kanglc/Hashtag/Pics/Hashtag_test_setup/msg-1409573976-1037.jpg

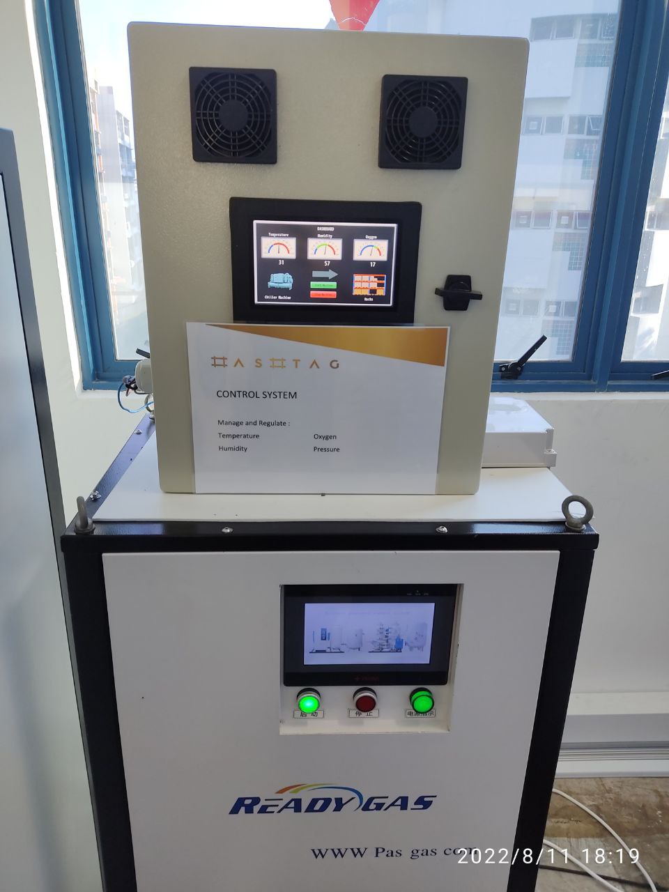
Pics/Hashtag_test_setup/msg-1409573976-1037.jpg
