kanglc/Hashtag/Docs/2-box-Control.docx

Liquid Nitrogen Tank

Frozen Pallet

Release valve

Sensor

Insulated Box

Liquid Nitrogen Tank

Frozen Pallet

Thermal Controller
