kanglc/Hashtag/Docs/thermal_controller_blockdiagram.pptx

Block Diagrams

## Slide 2

Thermal Controller

AC-DC
Converter

+24V

AC 230V

+5V

+12V

+5V

+12V

+24V

Relay Module

From Temp
Sensor

Modbus

Max485
Module

Microcontroller

NC

To Cryogenic
Control Valve

RTC

SD
Module

## Slide 3

Box 1 (RK330)

AC-DC
Converter

DC-DC
Converter

DC-DC
Converter

AC 230V

+24V

+12V

+5V

+12V

Microcontroller
(Arduino Uno)

10

DI

Max485
Module

RTC

LCD

RELAY

+5V

+12V

RK330-2
Sensor

GND

8

8

DE

RE

A

B

Modbus

SD
Module

+5V

Manual
Mode

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
Solenoid
Valve

ON/OFF

A3

3

4

IN1

IN2

COM

NO

+24V

GND

GND

## Slide 4

Box 1 (DHT22)

AC-DC
Converter

DC-DC
Converter

DC-DC
Converter

AC 230V

+24V

+12V

+5V

+12V

Microcontroller
(Arduino Uno)

+5V

DHT22
Module

GND

8

DHTPIN

+

SD
Module

+5V

Manual
Mode

GND

5

7

CLK

DAT

RTC

LCD

RELAY

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
Solenoid
Valve

ON/OFF

A3

3

4

IN1

IN2

COM

NO

+24V

GND

GND

## Slide 5

Box 1 (Max31855)

AC-DC
Converter

DC-DC
Converter

DC-DC
Converter

AC 230V

+24V

+12V

+5V

+12V

Microcontroller
(Arduino Uno)

10

+5V

CLK

Max31855
Module

GND

9

8

CS

DO

+

SD
Module

+5V

Manual
Mode

GND

5

7

CLK

DAT

RTC

LCD

RELAY

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
Solenoid
Valve

ON/OFF

A3

A0

A1

IN1

IN2

COM

NO

+24V

GND

GND

## Slide 6

Box 1 (Max31865+PT100)

AC-DC
Converter

DC-DC
Converter

DC-DC
Converter

AC 230V

+24V

+12V

+5V

+12V

Microcontroller
(Arduino Uno)

12

+5V

CLK

Max31865
Module

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
PT100

SD
Module

+5V

Manual
Mode

GND

5

7

CLK

DAT

RTC

LCD

RELAY

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
Solenoid
Valve

ON/OFF

A3

3

4

IN1

IN2

COM

NO

+24V

GND

GND

## Slide 7

Box 2 (Mega, Max31865+PT100)

AC-DC
Converter

DC-DC
Converter

DC-DC
Converter

Max31865
Module

AC 230V

+24V

+5V

+9V

+5V

+9V

Microcontroller
(Arduino Mega)

8

CLK

SD

Manual
Mode

MISO

GND

50

10

11

DI

CS

+

PT100

SCK

SS

53

52

9

GND

DO

MOSI

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
Module

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
ON/OFF

28

22

IN1

RELAY

COM

+24V

GND

Solenoid
Valve

20

21

SDA

SCL

GND

IN2

NO

## Slide 8

Distributed Controller

Main Controller (Mega)

AC 230V

AC-DC
Converter

+24V

Sub Controller (Uno) 1

Sub Controller (Uno) 2

Sub Controller (Uno) 3

Sub Controller (Uno) 4

DC-DC
Converter

Microcontroller (Uno)

+12V

Servo Motor

+5V

+12V

RTC

+5V

Microcontroller (Mega)

Max485
Module

Max485
Module

RK330
Sensor

Max485
Module1

Display

Max485
Module2

Max31865
Module

PT100
Sensor

Relay
Module

Max485
Module3

SD
Module

Max485
Module4

## Slide 9

Distributed Controller

+24V

DC-DC
Converter

+12V

DC-DC
Converter

+5V

+5V

Max31865
Module

Max485
Module

+12V

GND

Microcontroller
(Arduino Uno)

4

6

CLK

DI

+

+

PT100

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
Modbus

+12V

RK330-2
Sensor

Arduino
Mega

+24V

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
Max485
Module

DI

1

Modbus

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
SERVO

GND

RO

0

GND

V

G

Notes: Need to update pin numbers and arrow directions.

## Slide 10

Distributed Controller

+24V

DC-DC
Converter

+12V

DC-DC
Converter

+5V

+5V

Max31865
Module

DHT22
Module

+12V

GND

Microcontroller
(Arduino Uno)

4

6

CLK

DI

+

+

PT100

7

5

GND

CS

DO

8

+5V

DHTPIN

+

Arduino
Mega

+24V

GND

+5V

GND

Max485
Module

DI

1

Modbus

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
SERVO

GND

RO

0

GND

V

G

Notes: Need to update pin numbers and arrow directions.

## Slide 11

Master

Max485 Module

Slave 1

Max485 Module

Slave 2

Max485 Module

Slave 4

Max485 Module

Slave 3

Max485 Module

## Slide 12

Program Flowchart

## Slide 13

Setup:
Serial Terminal, Initialize variables, Display LEDs, RTC
Max31865, Relay, Mode and ONOFF Switches, microSD

Display temperature on LEDs & Serial Terminal

Manual Mode?

Read states of MODE and ONOFF switches

*

N

Cont on
next pg

Get time from RTC

Y

Turn on/off Relay and light corresponding LED according to ONOFF switch

Get temperature from Max31865

To*

## Slide 14

Cooling?

Turn on Relay and corresponding LED

N

Turn off Relay and corresponding LED

Temp < Upper Limit?

Turn off Relay and corresponding LED. Set cooling = true

Y

From
prev pg

N

N

Y

Temp < Lower Limit?

Turn off Relay and corresponding LED. Set cooling = false

N

Y

To*
