kanglc/Hashtag/Docs/Muang/2022-11-07_190520_Continental_Space Electronics.pdf

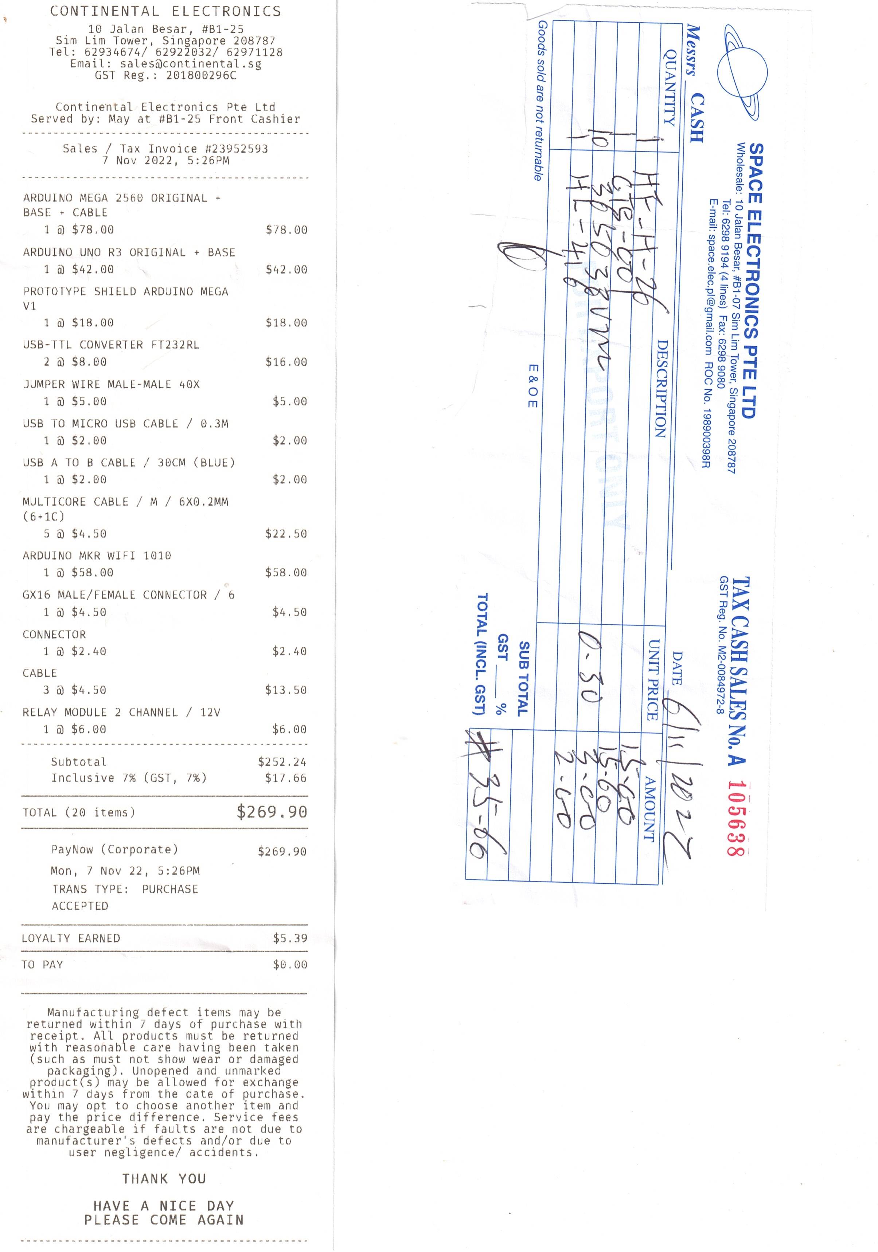
[picture p9: page 1]
