kanglc/Hashtag/Docs/Muang/2022-11-12_Continental Electronics.pdf

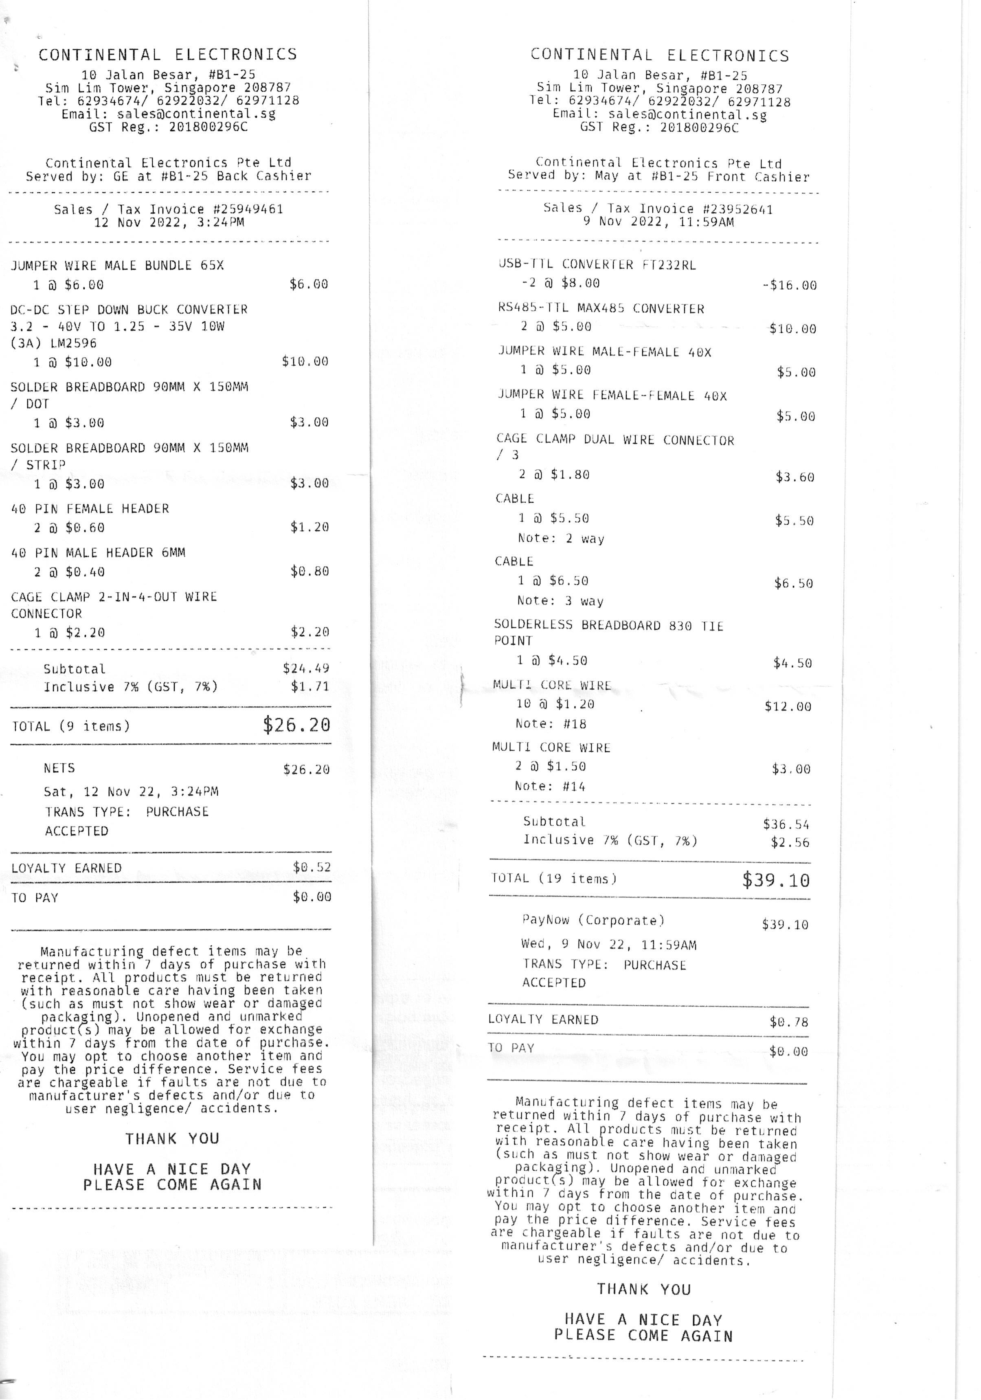
[picture p10: page 1]
