kanglc/Hashtag/Docs/Muang/2022-11-12_E-Top Electronics.pdf

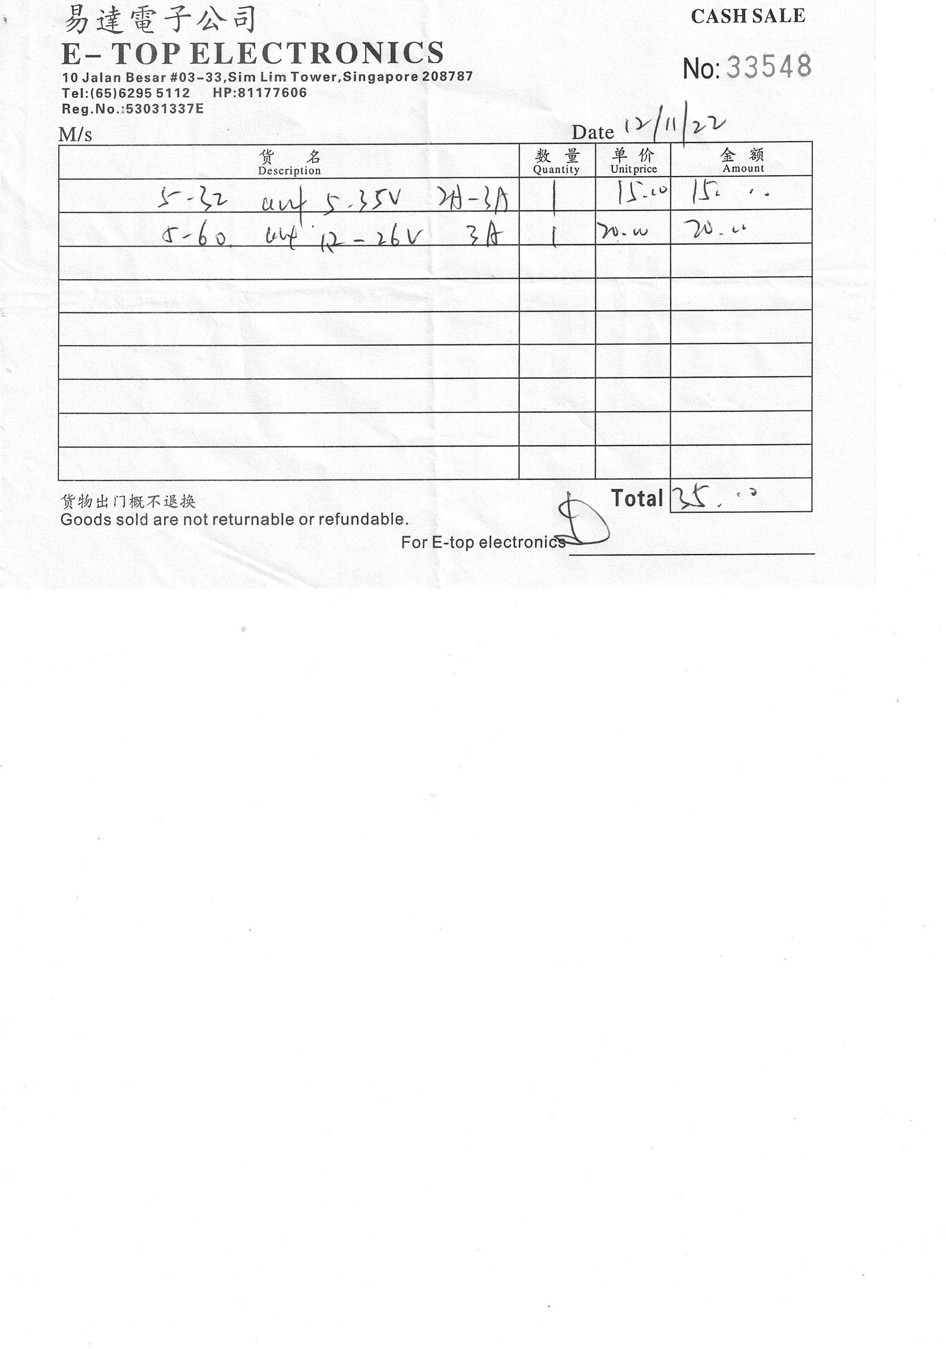
[picture p11: page 1]
