kanglc/Hashtag/Docs/Ref/RK330-02/使用手册.pdf

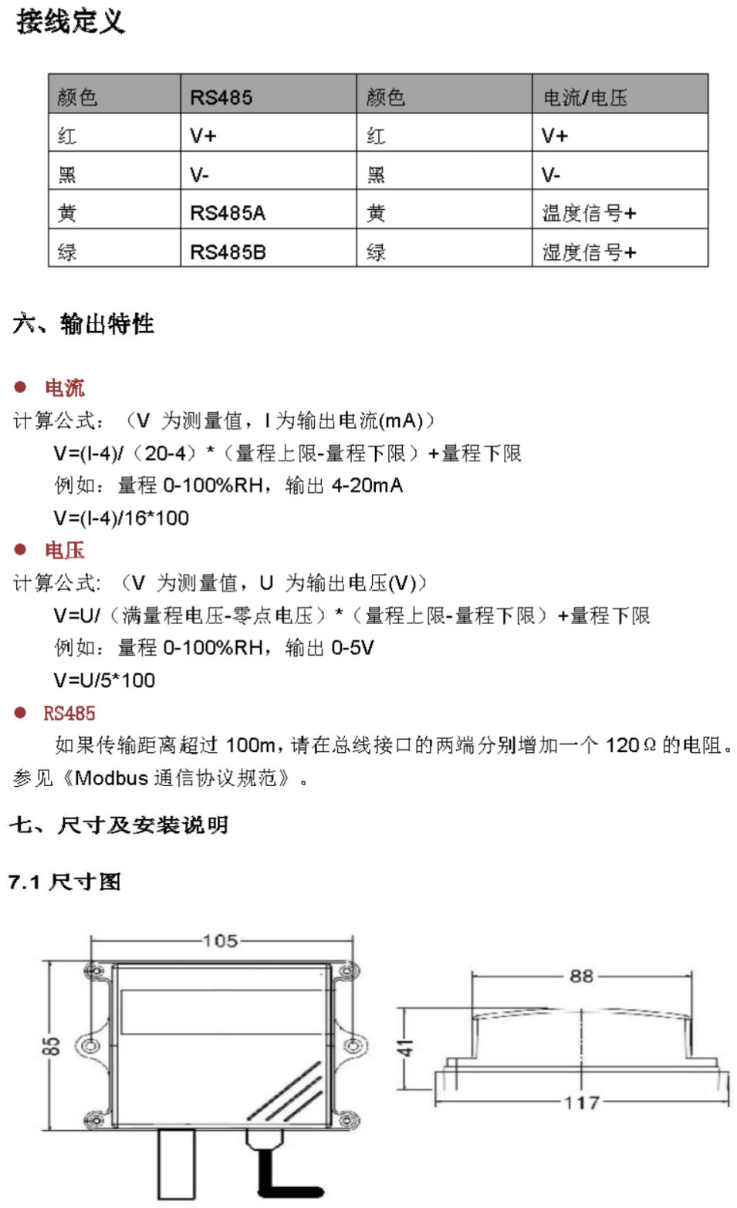
[picture p12: figure]
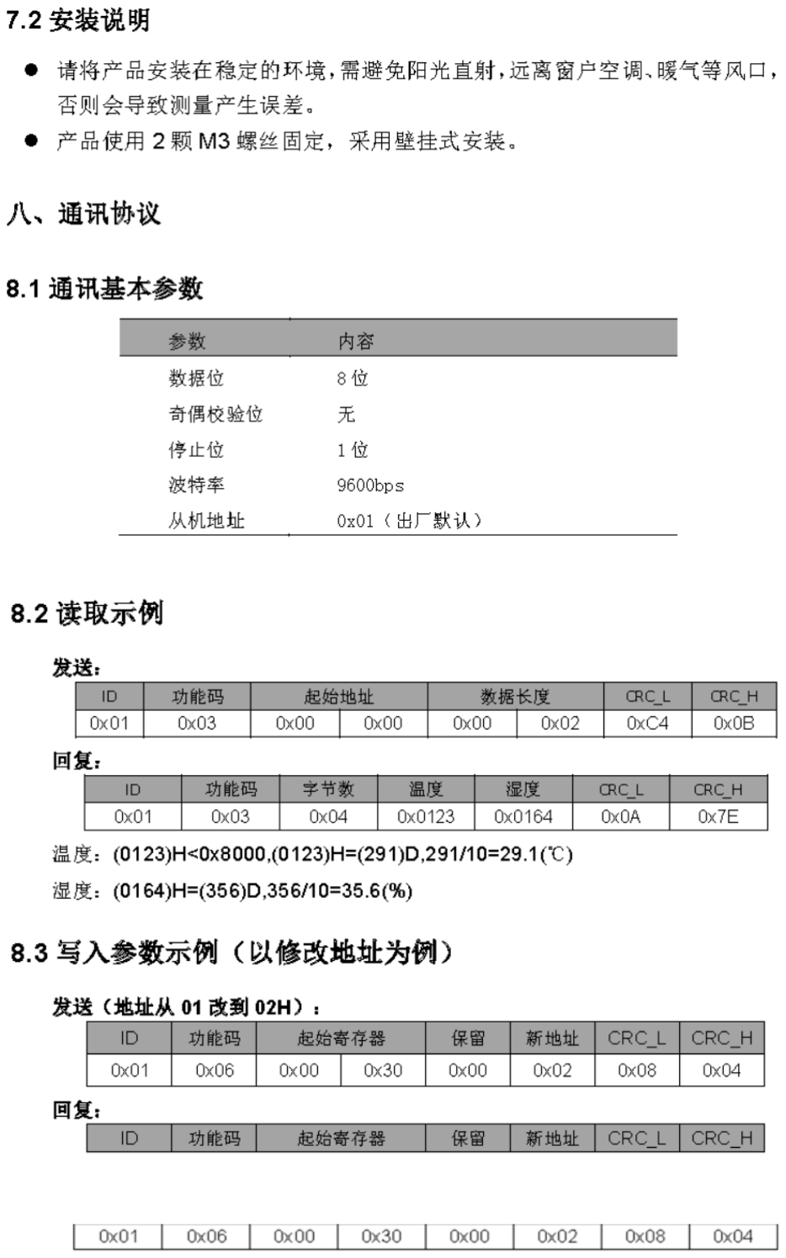
[picture p13: page 2]
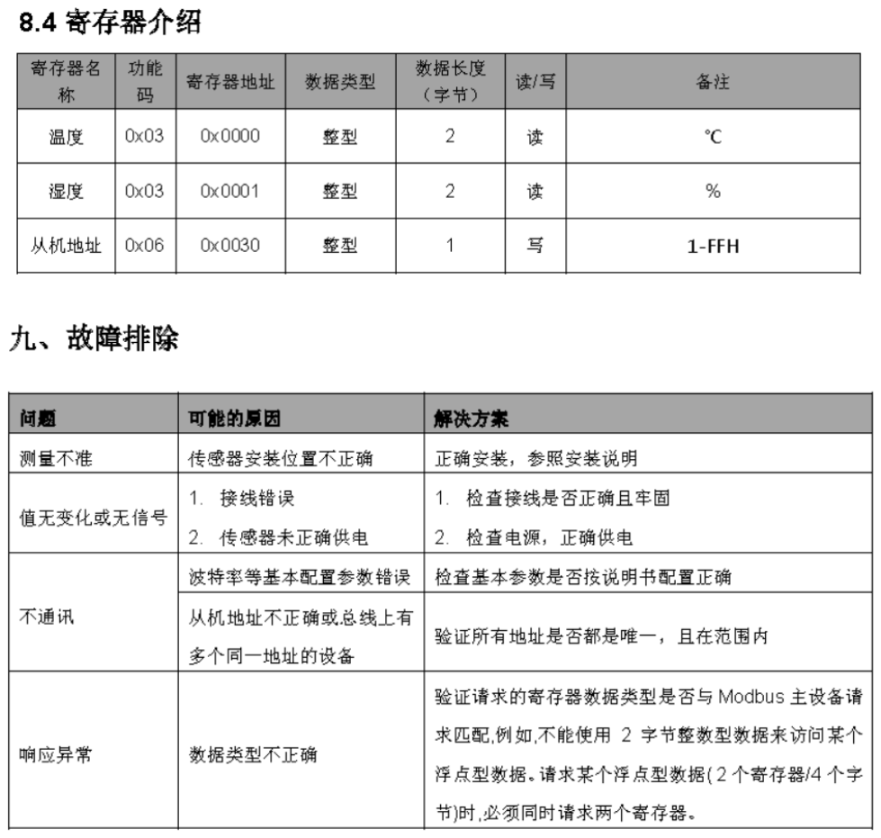
[picture p14: page 3]
