kanglc/Hashtag/Docs/Muang/2022-10-29 2.4inch TFT LCD Shield Tough Display Module.jpg

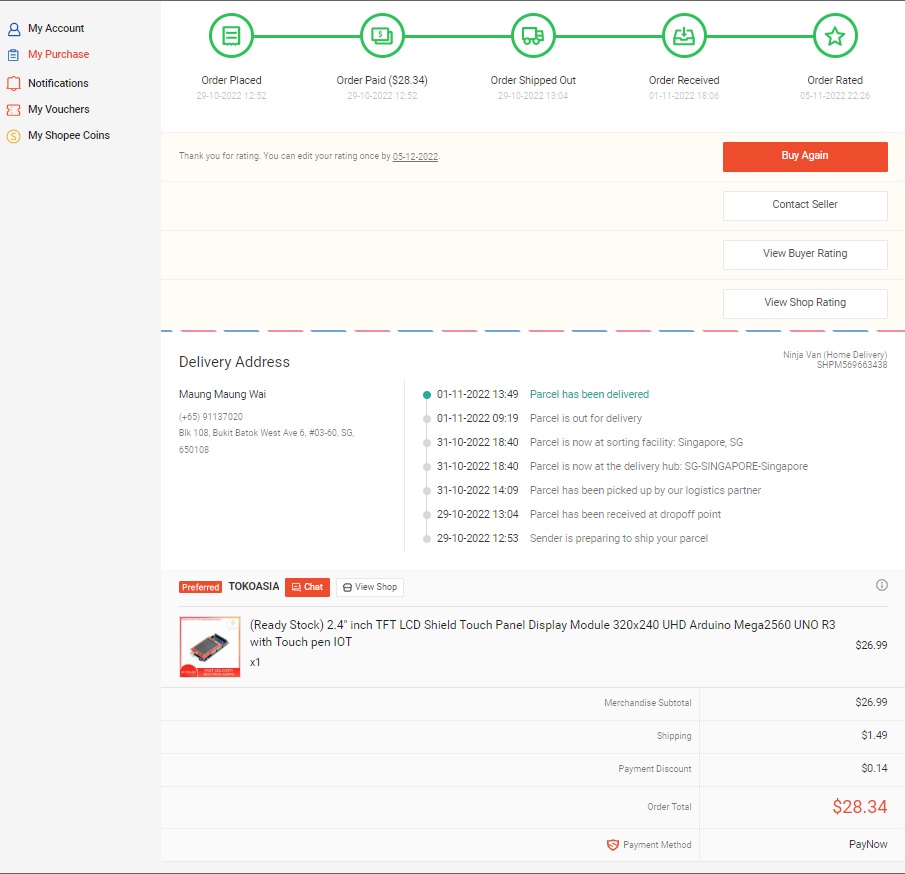
Docs/Muang/2022-10-29 2.4inch TFT LCD Shield Tough Display Module.jpg
