kanglc/Hashtag/Docs/Muang/2022-11-07 3.5inch 320x480 serial tft LCD module display.jpg

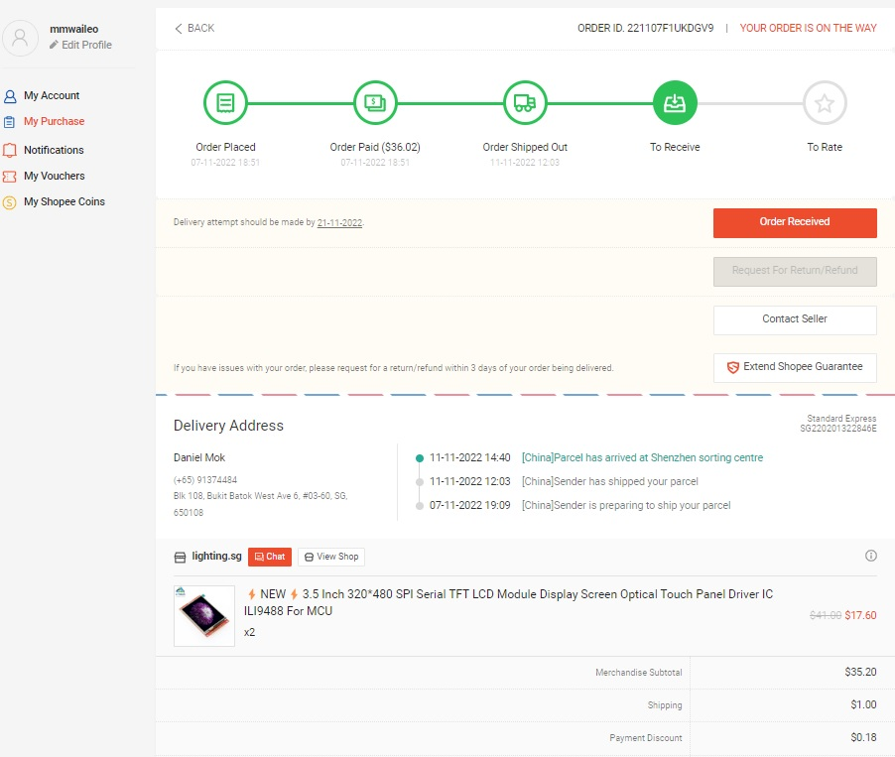
Docs/Muang/2022-11-07 3.5inch 320x480 serial tft LCD module display.jpg
