kanglc/Hashtag/Docs/Muang/2022-11-07 Dupont line 40pcs 20cm male-male.jpg

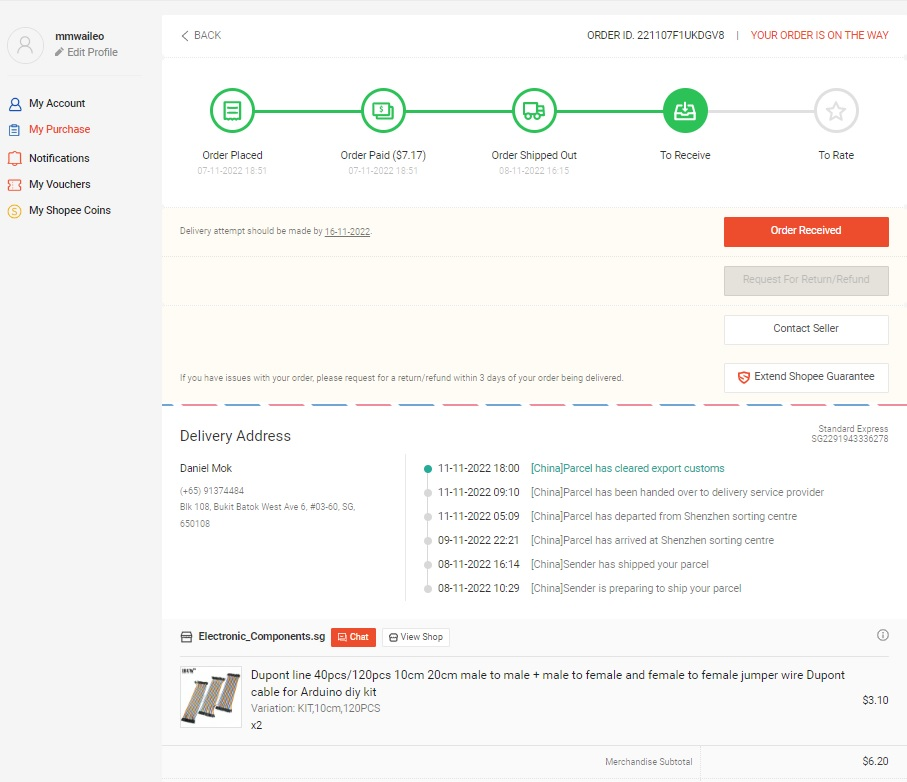
Docs/Muang/2022-11-07 Dupont line 40pcs 20cm male-male.jpg
