kanglc/Hashtag/Docs/Muang/2022-11-07 LM2596 Multi Channel Switching power supply DC-DC 3.3V-5V-12V.jpg

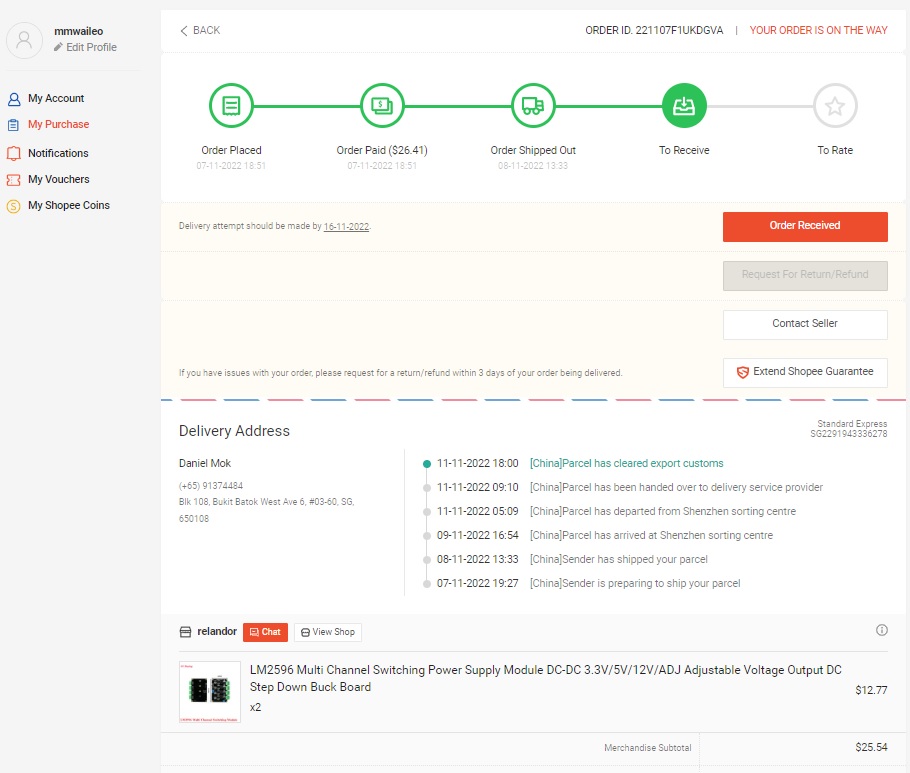
Docs/Muang/2022-11-07 LM2596 Multi Channel Switching power supply DC-DC 3.3V-5V-12V.jpg
