kanglc/Hashtag/Docs/Ref/Arduino_Mega.jpg

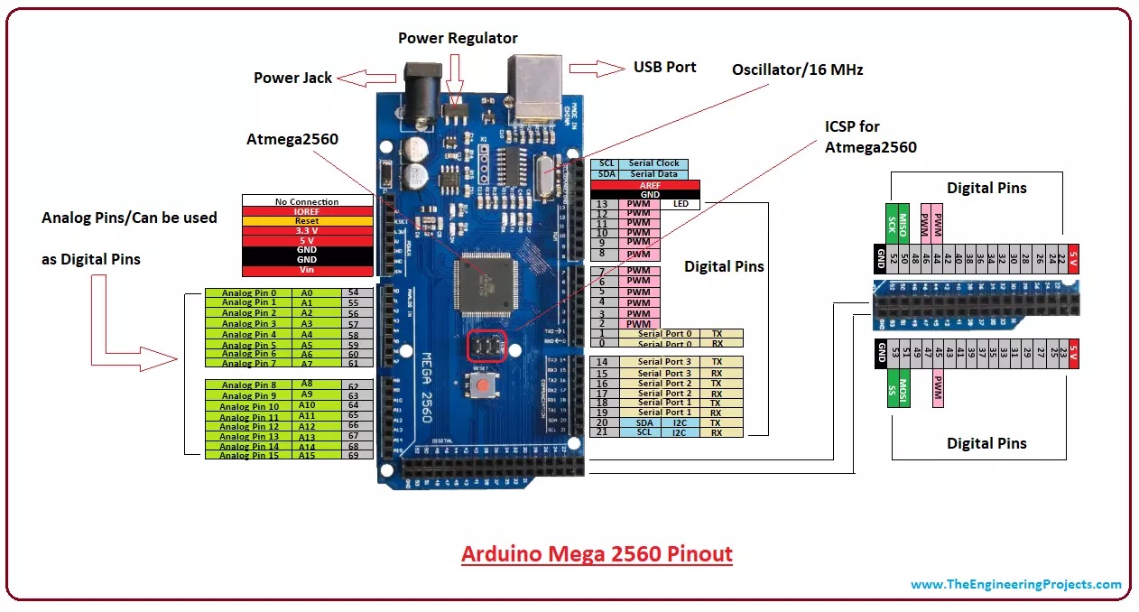
Docs/Ref/Arduino_Mega.jpg
