kanglc/Hashtag/Docs/Ref/servo.jpg

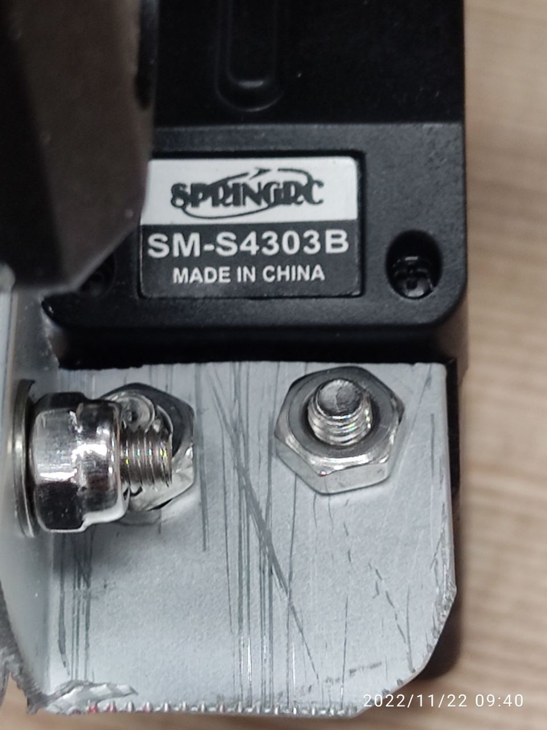
Docs/Ref/servo.jpg
