kanglc/Hashtag/Docs/temperature_log.jpg

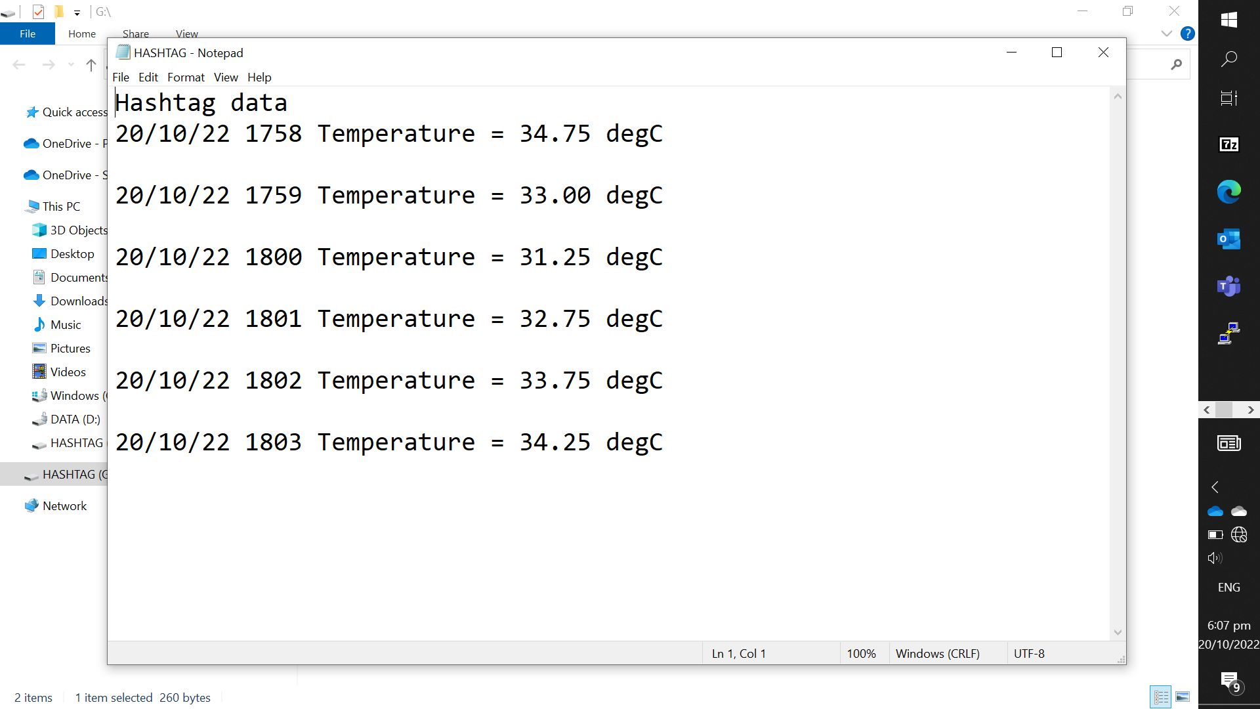
Docs/temperature_log.jpg
