kanglc/Hashtag/Docs/terminal.jpg

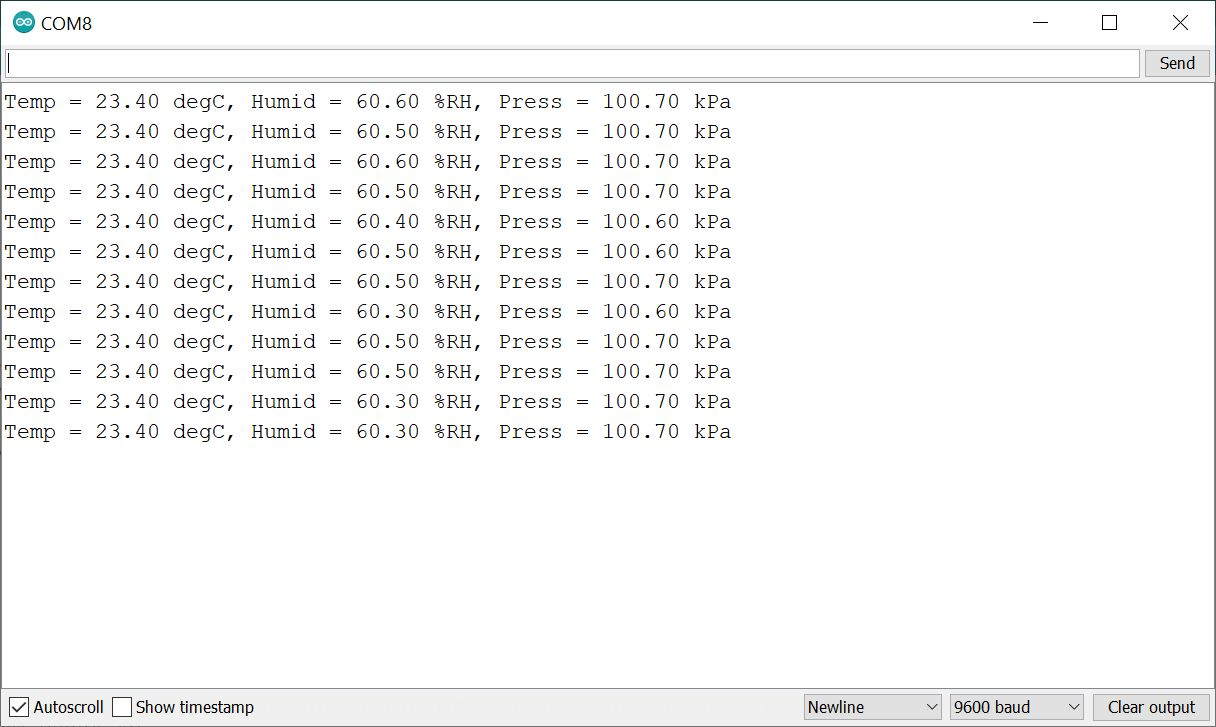
Docs/terminal.jpg
