kanglc/Hashtag/Docs/Hashtag_BOM.xlsx

Sheet: Unit 1
No | Component | Model | Qty | Price | Vendor
1 | Arduino Uno |  | 1 | 30.00 | Commonly available
2 | Max31865 Ampifier |  | 1 | 17.40 | RTD Temperature Sensor PT100 Amplifier MAX31865 (kuriosity.sg) (https://www.kuriosity.sg/rtd-temperature-sensor-pt100-amplifier-max31865/)
3 | PT100 RTD |  | 1 | 2.70 | PT100 Temperature Sensor High Resistant Control Probe Thermal Resistance K Type E Waterproof Fixed Thread 200mm Rod | Shopee Singapore (https://shopee.sg/PT100-Temperature-Sensor-High-Resistant-Control-Probe-Thermal-Resistance-K-Type-E-Waterproof-Fixed-Thread-200mm-Rod-i.770052582.21549034428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)
4 | RTC | DS1302 | 1 | 11.00 | Clock Module RTC DS3231 – Smart Engineering Solutions (continental.sg) (https://www.continental.sg/clock-module-rtc-ds3231.html)
5 | LED module |  | 1 | 11.00 | Gravity 4-Digital LED Segment Display Module (Red) – Smart Engineering Solutions (continental.sg) (https://www.continental.sg/gravity-4-digital-led-segment-display-module-red.html)
6 | Relay module |  | 1 | 9.90 | ARD 2-Channel Relay Shield Module for Arduino (Works with Official Arduino Boards) (sun-light.com.sg) (http://sun-light.com.sg/index.php?route=product/product&path=342_161&product_id=278)
7 | AC-DC power supply 24V 6.5A | Meanwell | 1 | 35.00 | Power Supply 24V 6.5A – Smart Engineering Solutions (continental.sg) (https://www.continental.sg/power-supply-24v-6-5a.html)
8 | DC-DC converter module 24-12V |  | 1 | 7.50 | sun-light.com.sg/index.php?route=product/product&product_id=2015&search=dc+dc+converter
9 | DC-DC converter module 12-5V | DFR0831 | 1 | 7.01 | DFR0831 - Dfrobot - Buck Converter Module, 7 V to 24 Vin, 5 Vout (element14.com) (https://sg.element14.com/dfrobot/dfr0831/buck-conv-module-7v-to-24vin-5vout/dp/3974104)
10 | microSD module | DFR0229 | 1 | 7.44 | DFR0229 - Dfrobot - Expansion Board, Micro SD(TF) Module, Arduino UNO/Mega Boards (element14.com) (https://sg.element14.com/dfrobot/dfr0229/micro-sd-module-arduino-uno-mega/dp/3769941?st=dfr0229)
11 | Casing (ABS/Polypropylene) |  | 1 | 15.00 | ABS Enclosure Waterproof 119x94x60mm / BWP 10515 – Smart Engineering Solutions (continental.sg) (https://www.continental.sg/abs-enclosure-waterproof-119x94x60mm-bwp-10515.html)
12 | Plug-in Terminal Block | 6way | 1 | 1.60 | Plug In Terminal Block – Smart Engineering Solutions (continental.sg) (https://www.continental.sg/plug-in-terminal-block.html)
 |  | 2way | 1 | 0.80 | Plug In Terminal Block – Smart Engineering Solutions (continental.sg) (https://www.continental.sg/plug-in-terminal-block.html)
13 | Vero Board |  | 1 | 3.00 | FR4 SINGLE SIDED DONUT VERO BOARD 1.6MM - 5 X 7 CM (sun-light.com.sg) (http://sun-light.com.sg/index.php?route=product/product&keyword=vero&product_id=3329)
14 | Switches, AC power connector |  | several | 10.00 | Commonly available
15 | Wirings, screws, nuts, standoffs |  | several | 10.00 | Commonly available
 |  |  |  | 179.35

Sheet: Unit 2
No | Component | Model | Qty | Price | Vendor
1 | Arduino Mega 2560 |  | 1 | 60.00 | Commonly available
2 | Max31865 Ampifier |  | 1 | 17.40 | RTD Temperature Sensor PT100 Amplifier MAX31865 (kuriosity.sg) (https://www.kuriosity.sg/rtd-temperature-sensor-pt100-amplifier-max31865/)
3 | PT100 RTD |  | 1 | 2.70 | PT100 Temperature Sensor High Resistant Control Probe Thermal Resistance K Type E Waterproof Fixed Thread 200mm Rod | Shopee Singapore (https://shopee.sg/PT100-Temperature-Sensor-High-Resistant-Control-Probe-Thermal-Resistance-K-Type-E-Waterproof-Fixed-Thread-200mm-Rod-i.770052582.21549034428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)
4 | RTC | DS1302 | 1 | 11.00 | Clock Module RTC DS3231 – Smart Engineering Solutions (continental.sg) (https://www.continental.sg/clock-module-rtc-ds3231.html)
5 | LED module |  | 1 | 11.00 | Gravity 4-Digital LED Segment Display Module (Red) – Smart Engineering Solutions (continental.sg) (https://www.continental.sg/gravity-4-digital-led-segment-display-module-red.html)
6 | Relay module |  | 1 | 9.90 | ARD 2-Channel Relay Shield Module for Arduino (Works with Official Arduino Boards) (sun-light.com.sg) (http://sun-light.com.sg/index.php?route=product/product&path=342_161&product_id=278)
7 | AC-DC power supply 24V 6.5A | Meanwell | 1 | 35.00 | Power Supply 24V 6.5A – Smart Engineering Solutions (continental.sg) (https://www.continental.sg/power-supply-24v-6-5a.html)
8 | DC-DC converter module 24-12V |  | 1 | 7.50 | sun-light.com.sg/index.php?route=product/product&product_id=2015&search=dc+dc+converter
9 | DC-DC converter module 12-5V | DFR0831 | 1 | 7.01 | DFR0831 - Dfrobot - Buck Converter Module, 7 V to 24 Vin, 5 Vout (element14.com) (https://sg.element14.com/dfrobot/dfr0831/buck-conv-module-7v-to-24vin-5vout/dp/3974104)
10 | microSD module | DFR0229 | 1 | 7.44 | DFR0229 - Dfrobot - Expansion Board, Micro SD(TF) Module, Arduino UNO/Mega Boards (element14.com) (https://sg.element14.com/dfrobot/dfr0229/micro-sd-module-arduino-uno-mega/dp/3769941?st=dfr0229)
11 | Casing (ABS/Polypropylene) |  | 1 | 15.00 | ABS Enclosure Waterproof 119x94x60mm / BWP 10515 – Smart Engineering Solutions (continental.sg) (https://www.continental.sg/abs-enclosure-waterproof-119x94x60mm-bwp-10515.html)
12 | Plug-in Terminal Block | 6way | 1 | 1.60 | Plug In Terminal Block – Smart Engineering Solutions (continental.sg) (https://www.continental.sg/plug-in-terminal-block.html)
 |  | 2way | 1 | 0.80 | Plug In Terminal Block – Smart Engineering Solutions (continental.sg) (https://www.continental.sg/plug-in-terminal-block.html)
13 | Vero Board |  | 1 | 3.00 | FR4 SINGLE SIDED DONUT VERO BOARD 1.6MM - 5 X 7 CM (sun-light.com.sg) (http://sun-light.com.sg/index.php?route=product/product&keyword=vero&product_id=3329)
14 | Switches, AC power connector |  | several | 10.00 | Commonly available
15 | Wirings, screws, nuts, standoffs |  | several | 10.00 | Commonly available
 |  |  |  | 209.35
