kanglc/Hashtag/Docs/Muang/2022-11-12 Parts bought for Cold Storage by mmwai.xlsx

List of Parts Bought for Cold Storage Project
Sr No | Description | Qty | Price/Unit | Shipping Cost | Discount | Total | Buying Date | Bought from | Remark
1 | 2.4inch TFT LCD Shield Tough Display Module | 1 | $26.99 | $1.49 | $0.14 | $28.34 | 2022-10-29 | Shopee
2 | Dupont line 40pcs 20cm male-male | 2 | $3.10 | $1.00 | $0.03 | $7.17 | 2022-11-07 | Shopee
3 | 3.5inch 320x480 serial tft LCD module display | 2 | $17.60 | $1.00 | $0.18 | $36.02 | 2022-11-07 | Shopee
4 | LM2596 Multi Channel Switching power supply | 2 | $12.77 | $1.00 | $0.13 | $26.41 | 2022-11-07 | Shopee
5 | PVC Box HF | 1 | $15.00 |  |  | $15.00 | 2022-11-06 | Space Electronics Pte Ltd, SLT
6 | Connector Clamping Tool | 1 | $15.60 |  |  | $15.60 | 2022-11-06 | Space Electronics Pte Ltd, SLT
7 | Connector fork | 10 | $0.30 |  |  | $3.00 | 2022-11-06 | Space Electronics Pte Ltd, SLT
8 | HL-416 | 1 | $2.00 |  |  | $2.00 | 2022-11-06 | Space Electronics Pte Ltd, SLT
9 | Arduino MEGA2560 Original + Base | 1 | $78.00 |  |  | $78.00 | 2022-11-07 | Continental Electronics, SLT
10 | Arduino UNO R3 Original + Base | 1 | $42.00 |  |  | $42.00 | 2022-11-07 | Continental Electronics, SLT
11 | Prototype Shield Arduino MEGA V1 | 1 | $18.00 |  |  | $18.00 | 2022-11-07 | Continental Electronics, SLT
12 | USB-TTL | 2 | $8.00 |  |  | $16.00 | 2022-11-07 | Continental Electronics, SLT
13 | Jumper wire male-male | 1 | $5.00 |  |  | $5.00 | 2022-11-07 | Continental Electronics, SLT
14 | USB to Micro USB | 1 | $2.00 |  |  | $2.00 | 2022-11-07 | Continental Electronics, SLT
15 | USB to Micro B cable | 1 | $2.00 |  |  | $2.00 | 2022-11-07 | Continental Electronics, SLT
16 | Multi core cable 5meter x 4.5 | 5 | $4.50 |  |  | $22.50 | 2022-11-07 | Continental Electronics, SLT
17 | Arduino MKR WIFI1010 | 1 | $58.00 |  |  | $58.00 | 2022-11-07 | Continental Electronics, SLT
18 | Male to femal connector | 1 | $4.50 |  |  | $4.50 | 2022-11-07 | Continental Electronics, SLT
19 | connector | 1 | $2.40 |  |  | $2.40 | 2022-11-07 | Continental Electronics, SLT
20 | Cable 3meter x 4.5 | 3 | $4.50 |  |  | $13.50 | 2022-11-07 | Continental Electronics, SLT
21 | Relay Module 2 channel 12V | 1 | $6.00 |  |  | $6.00 | 2022-11-07 | Continental Electronics, SLT
22 | GST | 1 | $17.66 |  |  | $17.66 | 2022-11-07 | Continental Electronics, SLT
23 | USB-TTL refund | 2 | -$8.00 |  |  | -$16.00 | 2022-11-09 | Continental Electronics, SLT
24 | RS485-TTL | 2 | $5.00 |  |  | $10.00 | 2022-11-09 | Continental Electronics, SLT
25 | Jumper wire male-female | 1 | $5.00 |  |  | $5.00 | 2022-11-09 | Continental Electronics, SLT
26 | Jumper wire female-female | 1 | $5.00 |  |  | $5.00 | 2022-11-09 | Continental Electronics, SLT
27 | Clamp Dual wire connector | 2 | $1.80 |  |  | $3.60 | 2022-11-09 | Continental Electronics, SLT
28 | Cable 2 ways | 1 | $5.50 |  |  | $5.50 | 2022-11-09 | Continental Electronics, SLT
29 | cable | 1 | $6.50 |  |  | $6.50 | 2022-11-09 | Continental Electronics, SLT
30 | Solderless breadboard | 1 | $4.50 |  |  | $4.50 | 2022-11-09 | Continental Electronics, SLT
31 | Multi core wire | 10 | $1.20 |  |  | $12.00 | 2022-11-09 | Continental Electronics, SLT
32 | Multi core wire | 2 | $1.50 |  |  | $3.00 | 2022-11-09 | Continental Electronics, SLT
33 | GST | 1 | $2.56 |  |  | $2.56 | 2022-11-09 | Continental Electronics, SLT
34 | Jumper wire male Bundle 65pcs | 1 | $6.00 |  |  | $6.00 | 2022-11-12 | Continental Electronics, SLT
35 | DC-DC Step down Buck converter 3A LM2596 | 1 | $10.00 |  |  | $10.00 | 2022-11-12 | Continental Electronics, SLT
36 | Solder Breadboard 90x150mm DOT | 1 | $3.00 |  |  | $3.00 | 2022-11-12 | Continental Electronics, SLT
37 | Solder Breadboard 90x150mm Strip | 1 | $3.00 |  |  | $3.00 | 2022-11-12 | Continental Electronics, SLT
38 | 40 pin Female Header | 2 | $0.60 |  |  | $1.20 | 2022-11-12 | Continental Electronics, SLT
39 | 40 pin male Header | 2 | $0.40 |  |  | $0.80 | 2022-11-12 | Continental Electronics, SLT
40 | Cage Clamp 2-IN-4-OUT wire | 1 | $2.20 |  |  | $2.20 | 2022-11-12 | Continental Electronics, SLT
41 | GST | 1 | $1.71 |  |  | $1.71 | 2022-11-12 | Continental Electronics, SLT
42 | DC-DC 5-35 IN - 5-32V Out converter 2-3A | 1 | $15.00 |  |  | $15.00 | 2022-11-12 | E-Top Electronics
43 | DC-DC 5-60 IN - 12-26V Out converter 3A | 1 | $20.00 |  |  | $20.00 | 2022-11-12 | E-Top Electronics
44 | 230V AC to 24V DC 14.5A Power Supply | 1 | $32.00 |  |  | $32.00 |  |  | No receipt
 |  |  |  |  |  | $557.67
