kanglc/Hashtag/Docs/Muang/Muangs_partslist.jpg

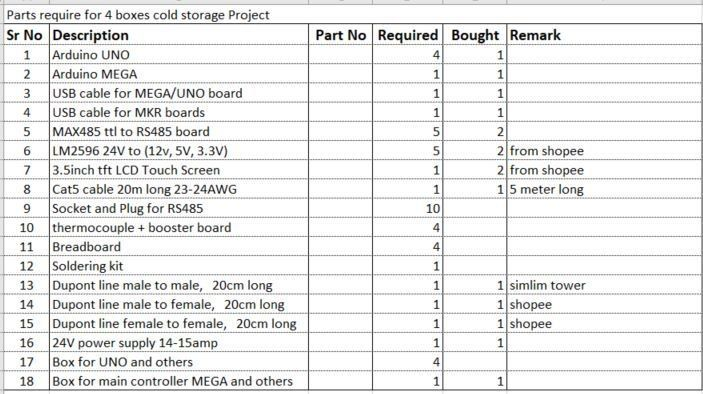
Docs/Muang/Muangs_partslist.jpg
