kanglc/Hashtag/Pics/Hashtag_test_setup/msg-1409573976-1011.jpg

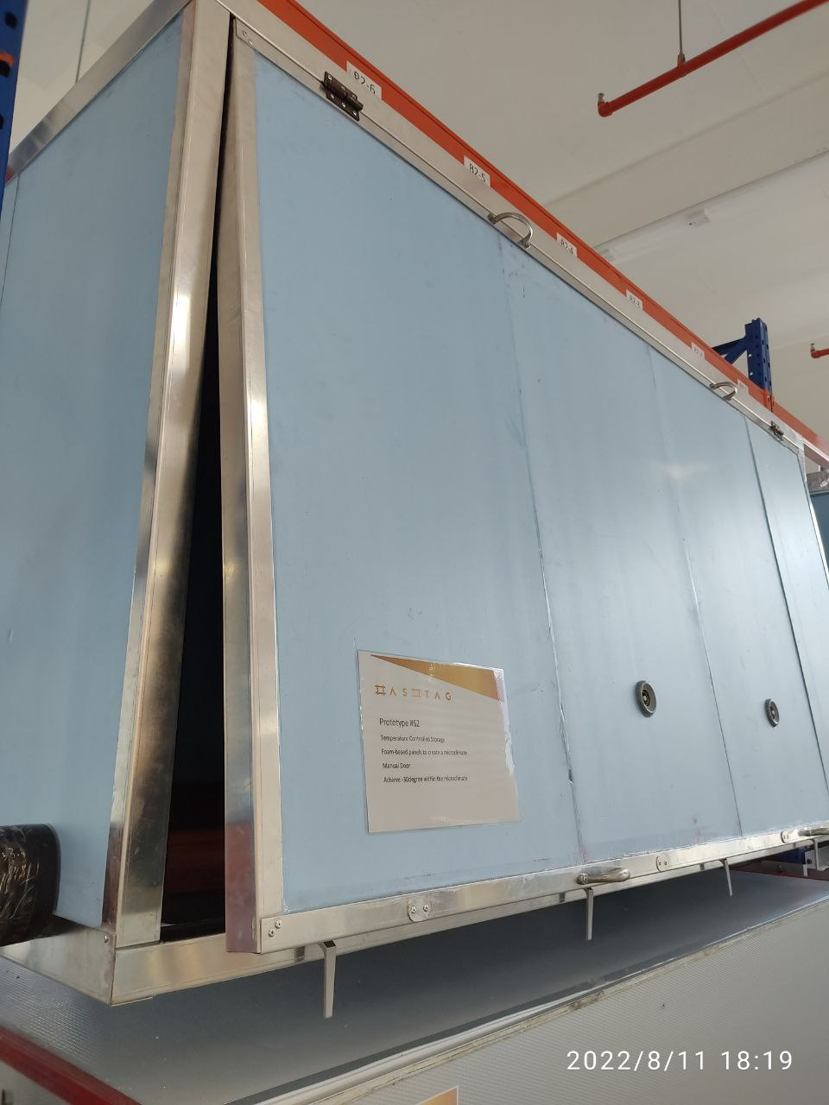
Pics/Hashtag_test_setup/msg-1409573976-1011.jpg
