kanglc/Hashtag/Docs/debug.jpg

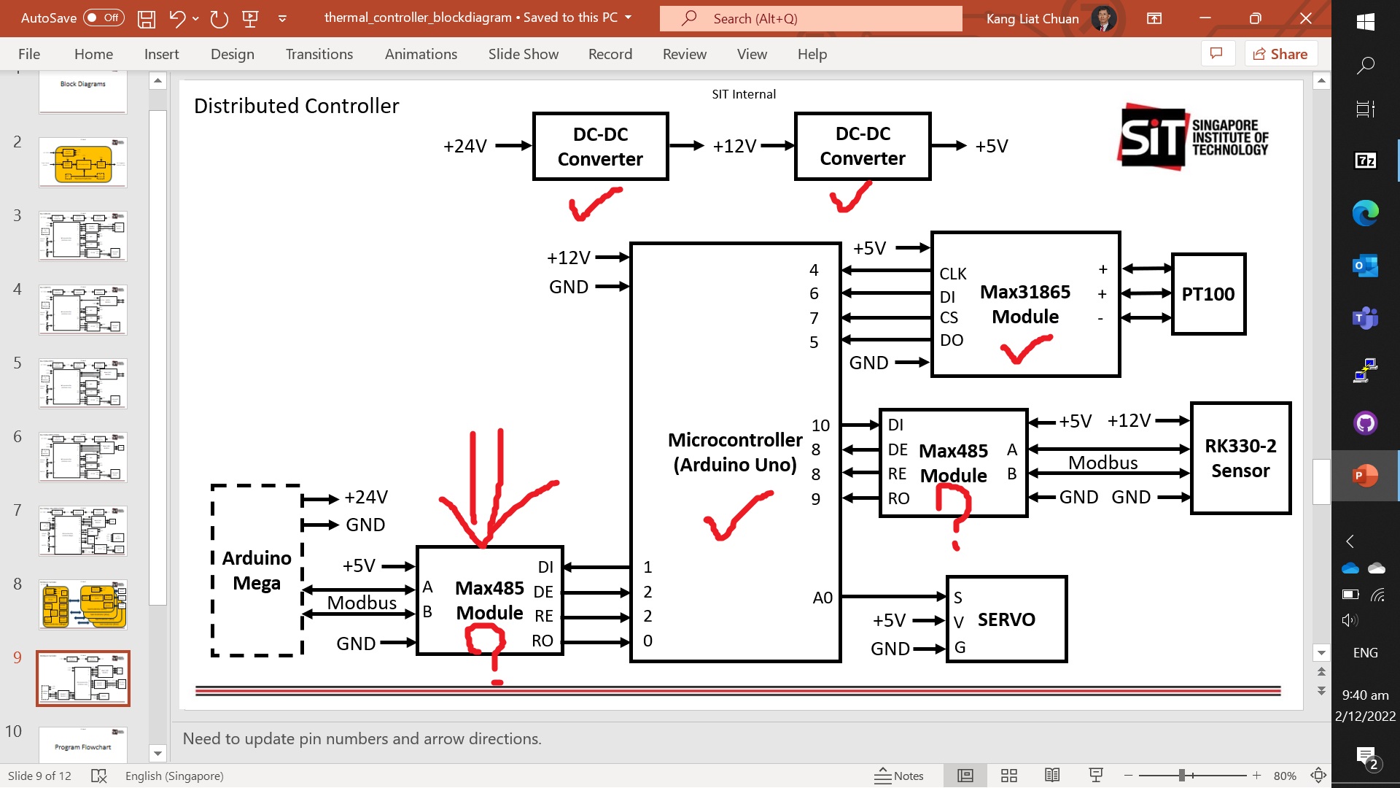
Docs/debug.jpg
