kanglc/Hashtag/Docs/Ref/4D Systems/pixxilcd-25p4_drawing_r_2_0.pdf

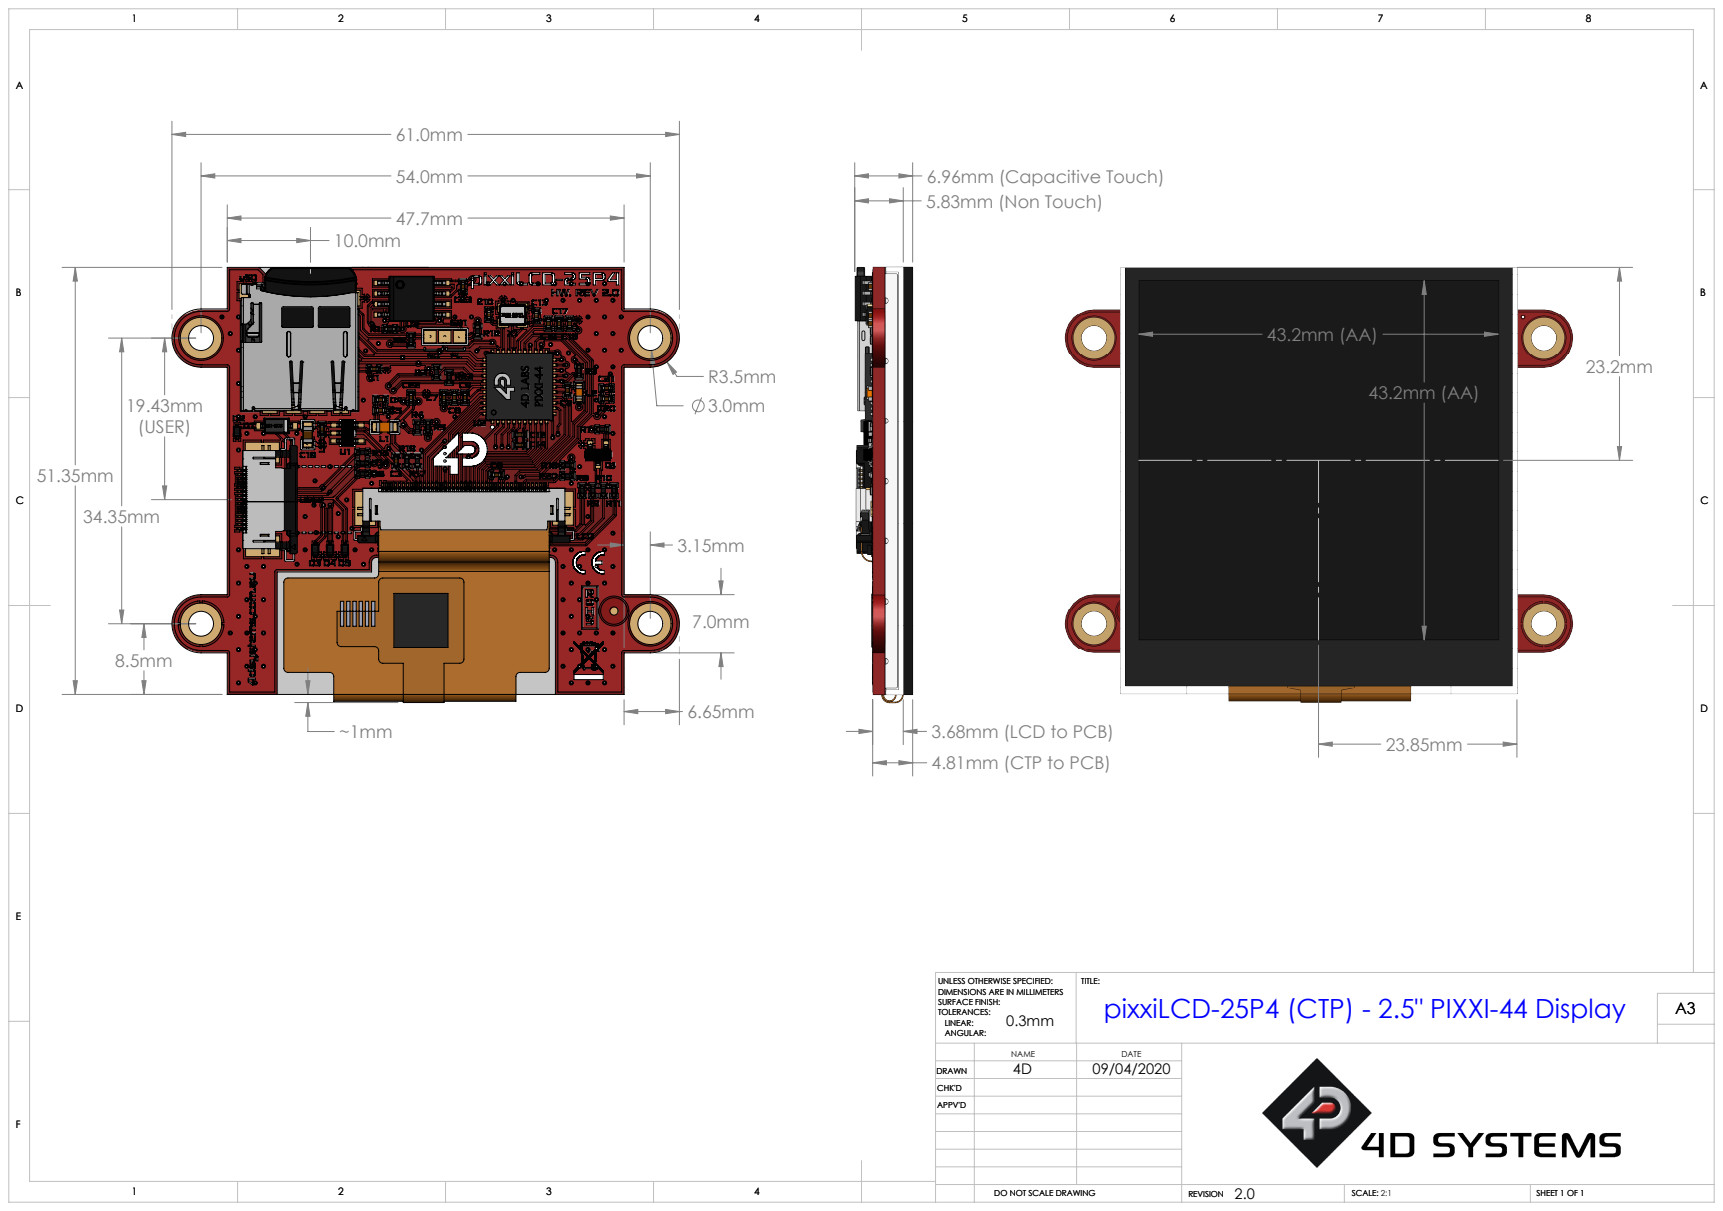
[picture p34: page 1]
5.83mm (Non Touch); 6.96mm (Capacitive Touch); DO NOT SCALE DRAWING; REVISION; SCALE:; SHEET 1 OF 1; SCALE: 2:1

3.68mm (LCD to PCB)
4.81mm (CTP to PCB)

UNLESS OTHERWISE SPECIFIED: UNLESS OTHERWISE SPECIFIED: DIMENSIONS ARE IN MILLIMETERS DIMENSIONS ARE IN MILLIMETERS SURFACE FINISH: SURFACE FINISH: TOLERANCES: TOLERANCES: 0.3mm LINEAR: LINEAR: ANGULAR: ANGULAR: | TITLE:

pixxiLCD-25P4 (CTP) - 2.5" PIXXI-44 Display

NAME | DATE

DRAWN | 4D | 09/04/2020

CHK'D
APPV'D
