kanglc/Hashtag/(commit log)

2022-09-28 Sources
    This reverts commit e7e82a22ba67e8613fc3413a4ad82454327f27d1.
    [LCD_Keypad_Shield_Demo.ino, Touch_shield_new.ino, test_relay.ino, test_sensor.ino]
2022-10-12 Update Hashtag source
    Read negative temperature.
2022-11-04 Added BOM list
    [Hashtag_BOM.xlsx]
2022-11-05 Add test_rk330
    China recalibrated the RK-330 sensor to solve the no negative temperature issue.
    [test_rk330.ino]
2022-11-15 Max31865_RK330_Uno
    Uno has a modbus master reading from RK330, and as a modbus slave sending data to/from mega. Temperature is taken from Max31865.
2022-11-16 Muang
    Receipts
    [2022-11-12 Parts bought for Cold Storage by mmwai.xlsx]
2022-11-17 Added Servo codes
    To Uno. Mega master can write 0/1/2 to control Uno servo to 0/90/180 deg.
2022-11-17 Update servo codes
    Open and Close positions only. Currently set to 90 deg and 0 deg respectively.
2022-12-09 4Uno design
    Using 4 Uno as slaves and 1 Mega as master. RK330 is replaced by DHT22, but only taking the humidity reading.
    [Hashtag_Max31865_4Uno.ino, test_Mega.ino]
2023-04-05 Source Codes
    Change 1:1 and 1:2 (previously 1:4) systems with auto-close servo vent.
